bg4uvr/esp8266mws/doc/pic/8266-wifi-save.jpg

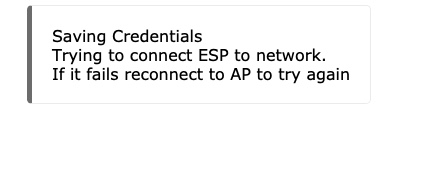
doc/pic/8266-wifi-save.jpg
