bg4uvr/esp8266mws/doc/pic/esp-tiaoshi1.jpg

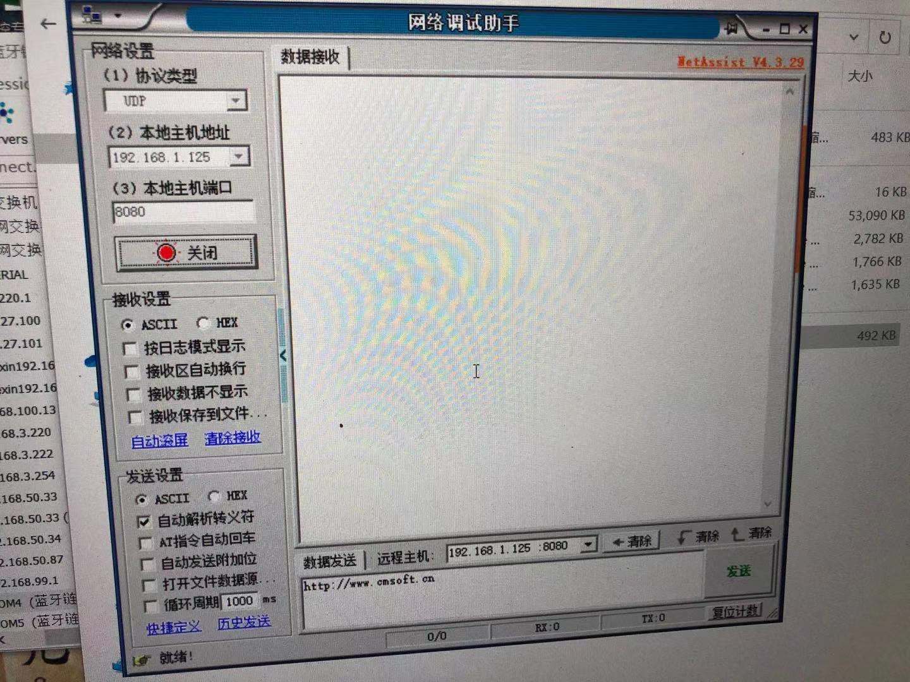
doc/pic/esp-tiaoshi1.jpg
