bg4uvr/esp8266mws/(commit log)

2021-05-03 修正华氏温度值直接由浮点数计算，而不是浮点数转换成整数再计算
2021-05-03 数据更新间隔调整为10分钟
2021-05-04 1、将发送定时由ticker完成，改为由millis()来完成。2、bmp280检测失败时，运行OTA扫描任务而不是直接挂起。
2021-05-04 删除判断是否到达发送间隔时，不必要的溢出判断。
2021-05-04 主循环中加入WiFi连接状态检测
2021-05-04 发送数据备注消息中，增加发包计数和运行分钟数显示
2021-05-05 增加心跳包接收超时检测，超时后将主动关闭当前连接并重新连接
2021-05-05 加入湿度
2021-05-05 更改vscode缩进为2空格
2021-05-05 修正存储和比较最后发送时间以及接收时间的逻辑
2021-05-05 修复验证后马上发送第一次数据
2021-05-06 更改vscode配置
2021-05-06 更改vscode设置
2021-05-06 vscode下重新格式化
2021-05-06 更新vscode配置
2021-05-06 无湿度版，不修改库文件自定义i2c端口成功
2021-05-06 加入湿度功能
2021-05-06 dht11、bmp280单独单次读取
2021-05-06 增加局域网调试监控连接
2021-05-06 删除读取bmp函数内部的串口消息
2021-05-06 修改esp8266板参数
2021-05-07 串口网络同时监控，湿度使用RX
2021-05-07 LAN调试由wificlient更改为 wifi server模式
2021-05-07 led状态单独写成函数，增加了一点注释
2021-05-07 加入湿度平滑滤波功能
2021-05-07 湿度滤波次数更改为5次
2021-05-07 aprs服务器心跳包超时时间更改为1分钟
2021-05-08 修改build目录
2021-05-08 更改为nodemcu板
2021-05-08 已更改为使用休眠功能，使用2032电池供电
2021-05-08 1、取消DHT11软件滤波，增加返回结果范围限制 2、BMP280更改为FORCE模式，并更改参数以省电 3、停止发送数据电压从低于3.3V改为低于3.5V 4、非调试状态时，不初始化串口
2021-05-08 传感器读取失败时，设置一个较合理的默认输出值
2021-05-09 更改休眠唤醒逻辑
2021-05-10 1、修改.gitignore文件，不再包含.vscode目录 2、修正电压低时最后一条语句过长的BUG 3、修正电压掉电时，未设置休眠时间的BUG 4、修改代码，为加入局域网监控、OTA、以及局域网设置参数功能做准备
2021-05-10 重新修复休眠时间计算BUG
2021-05-13 新加入局域网监控、OTA、以及局域网设置参数功能已基本可用，有待仔细测试及优化。
2021-05-13 优化完善一些结构和细节
2021-05-14 加入AHT20传感器支持
2021-05-14 优化一点细节，装机实测
2021-05-14 修正休眠时间计算；修正调试模式连接断开后立即休眠，而不是再重新运行一遍主循环。
2021-05-14 修正休眠秒数计算
2021-05-14 修正100%的湿度值显示
2021-05-14 取消湿度值主动范围限制
2021-05-15 1、天气报告中空数据由‘0’改为‘.’，删除不必要的‘r','p'数据段。 2、更改发送的目标地址为APUVR
2021-05-15 调整了ADC计算满量程电压值
2021-05-17 删除支持DHT11的代码，准备修改配置命令方式，配置增加默认参数，增加端口引脚自定主我，增加多语言支持。
2021-05-19 1、相应传感器读取失败时，空白数据设置为 "." 2、两个传感器都正常时，温度数据由两个传感器结果平均得出 3、更改配置命令格式及实现方法
2021-05-19 修正平均温度计算错误，修正休眠时间计算错误，修正登录失败时不再强制进入配置模式
2021-05-19 修正为登录验证失败也发送数据
2021-05-19 修改了一点细节
2021-05-19 修改了一处注释
2021-05-20 电压测量更改为直接从VCC脚来测量
2021-05-20 默认停机电压更改为3.2V，修复停机电压、重启电压参数按整数获取而未按浮点数获取的错误。
2021-05-21 1、修正ADC整数转换浮点数的错误 2、修正配置命令只有第一次才有效的错误
2021-05-21 1、修复电压高于4.2V时发送间隔计算错误 2、初步准备多语言实施方式
2021-05-21 多语言支持初步完成
2021-05-21 更改文件名
2021-05-22 注释全部加入英文翻译
2021-05-22 加入readme.md
2021-05-22 删除非pub版的readme.md
2021-05-25 合并pub版本
2021-05-25 修复附加消息中字符与气象数据冲突的错误
2021-05-26 大于大于4.2V时不休眠，直到电压低于4.1V；增加用户自定义消息；完善配置参数的合法性检查。
2021-05-27 修正命令行格式的提示内容；完善用户自定义消息的清空方法；优化过充保护部分的代码；断开连接后休眠前加入延时，以正确关闭连接
2021-05-31 修正完善提示消息中显示的命令格式说明
2021-06-07 修正两处文字错误
2021-06-07 删除用户自定义消息命令（可以在代码中加入和修改）；修改部分参数默认值；版本号0.12
2021-06-07 Create newbie-setup.md
    慢慢写。
2021-06-07 新手调试过程
2021-06-08 上传文档插图
2021-06-08 新手教学-更新
2021-06-08 修正部分文字
2021-08-22 1、修正aprs.cn不显示气象台站消息 2、增加调试时重启命令 rst 3、增加软件版本消息 4、修正几处文字错误 5、删除一处空函数 6、release 0.13
    [esp8266mws.ino]
2021-08-26 发送完数据后加入延迟，避免过快关闭连接，造成数据实际发送失败
2021-08-26 电池电压mV值个位为0时才发送版本消息，以降低频次
2021-08-27 fix route & adj relay time
    [esp8266mws.ino]
2021-08-30 优化网络连接超时判断逻辑
2021-09-02 修复弱信号高干扰高延迟网络状态下有概率丢包的问题
2021-09-06 进一步降低自定义消息发送频度，改变了发送时机选择方法
2021-09-08 自定义消息从随机发送更改为定时发送
2021-09-24 更新readme.md文件
2021-09-25 添加许可证，修改一处漏字
2021-09-29 更新说明文档
2021-09-29 修正一处文字录入错误
2021-10-15 再次修正多余的路径
2021-10-15 修正函数先后顺序引起的调用错误
2021-10-16 更新readme文件
2021-11-03 1、修复经纬度无法设置为较小数值的BUG 2、修改了默认服务器和经纬度，它们不再是要求必设的参数 3、版本号更新为0.15f
2021-12-31 修复内存泄漏 https://gitee.com/bg4uvr/esp8266mws/issues/I4OT4E
2022-01-15 增加关闭VCC检测的开关，增加版本号字符串变量
2022-01-15 修改电池防过充保护电压值为：超过4.3V不休眠，直到降到4.2V
2022-01-17 把.vscode设置保存在代码中
2022-01-18 修正readme.md中关于RST脚470欧电阻的说明；完善一处可能造成休眠时间意外过长的不严谨的代码
2022-01-18 重新表述D0脚与RST脚之间外接电阻的说明
2022-01-19 删除错误包含Time.h，因为这将会使代码在linux系统下无法编译
2022-01-22 设置.gitignore文件跳过.vscode目录
2022-08-15 修正消息类型字符
2023-03-24 修复新版ArduinoIDE内置函数与代码私有函数重名编译出错问题
2024-10-02 取消电压检测功能
2024-10-02 消息语句增加电压ADC值，重新格式化代码
2024-10-06 整理说明文件
2024-11-28 修正保护板接法说明及接线图
